enriquemf15/modular-bms/BOM_BMS_PCB.xlsx

Designacion | Reference | Quantity | Value | Footprint | RS Number | RS Link | Inventario | Pedir | Utilizadas | Quedan
C1 | C1 C3 C6 | 3 | 2,2 uF | 1206 | 144-7280 | Condensador 2,2uF (https://es.rs-online.com/web/p/condensadores-ceramicos-multicapa/1447280/) | 40 | 0 | 3 | 37
C21 | C11 C14 C17 C20 C23 C26 | 6 | 2.2 uF | 805 | 885-1685 | Condensador 2.2uF - Filtro (https://es.rs-online.com/web/p/condensadores-ceramicos-multicapa/8851685/) | 0 | 60 | 6 | 54
C5 | C29 C30 C31 C32 C33 C34 | 6 | 33 pF | 805 | 264-4264 | Condensador 33pF (https://es.rs-online.com/web/p/condensadores-ceramicos-multicapa/2644264/) | 57 | 0 | 0 | 57
C4 | C28 | 1 | 10 nF | 603 | 698-3213 | Condensador 10nF (https://es.rs-online.com/web/p/condensadores-ceramicos-multicapa/6983213/) | 97 | 0 | 0 | 97
C31 | C2 C5 C9 C12 C15 C18 C21 C24 C27 | 9 | 0,1 uF | 805 | 723-5048 | Condensador 0,1uF (https://es.rs-online.com/web/p/products/7235048/) | 0 | 100 | 9 | 91
C6 | C4 | 1 | 10 uF | 1206 | 790-0613 | Condensador 10uF (https://es.rs-online.com/web/p/condensadores-ceramicos-multicapa/7900613/) | 17 | 0 | 1 | 16
C7 | C7 C8 | 2 | 47 nF | 603 | 135-6600 | Condensador 47nF (https://es.rs-online.com/web/p/condensadores-ceramicos-multicapa/1356600/) | 44 | 0 | 0 | 44
D1 | D1 | 1 | TVS | SMA | 795-8565 | TVS (https://es.rs-online.com/web/p/products/7958565/) | 17 | 0 | 1 | 16
D2 | D2 | 1 | LED | 603 | 861-0090 | LED (https://es.rs-online.com/web/p/led-visibles/8610090/) | 46 | 0 | 1 | 45
D3 | D3 D4 D5 D6 D7 D8 D9 D10 D11 D12 D13 D14 | 12 | Zener 5,1V | SOD-123F | 738-4951 | Zener (https://es.rs-online.com/web/p/diodos-zener/7384951/) | 160 | 0 | 12 | 148
J2 | J3 | 1 | Switch_3P_SPST | Switch | 718-2140 | Interruptor 3P (https://es.rs-online.com/web/p/interruptores-dip-y-sip/7182140/) | 7 | 0 | 0 | 7
- | J1 J5 J9 J14 | 1 | Conn_01x08 | Pin | - | - | - | - | - | -
J1 | J2 | 1 | IDC | IDC 2x5 | 832-3581 | IDC 2x5 (https://es.rs-online.com/web/p/conectores-macho-para-pcb/8323581/) | 8 | 0 | 1 | 7
J3 | J12 J13 J7 | 3 | Switch_8P_DIP_SPST | Switch | 718-2180 | Interruptor 8P (https://es.rs-online.com/web/p/interruptores-dip-y-sip/7182180/) | 10 | 0 | 2 | 8
U1 | Q1 Q2 Q3 Q4 Q5 Q6 | 6 | NMOS | SOT | 737-7228 | NMOS (https://es.rs-online.com/web/p/transistores-mosfet/7377228/) | 61 | 0 | 6 | 55
R4 | R3 R63 R64 R65 | 4 | 100K | 1206 | 901-3746 | 100K (https://es.rs-online.com/web/p/resistencias-fijas-para-montaje-en-superficie/9013746/) | 97 | 0 | 1 | 96
R2 | R11 R16 R21 R26 R31 R36 | 6 | 33 | 1206 | 721-9706 | 33 (https://es.rs-online.com/web/p/resistencias-fijas-para-montaje-en-superficie/7219706/) | 53 | 10 | 6 | 57
R3 | R10 R12 R15 R17 R20 R22 R25 R27 R30 R32 R35 R37 R55 | 13 | 1K | 603 | 213-2266 | 1K (https://es.rs-online.com/web/p/resistencias-fijas-para-montaje-en-superficie/2132266/) | 155 | 0 | 13 | 142
R1 | R1 R13 R18 R23 R28 R33 R38 | 7 | 1M | 603 | 213-2676 | 1M (https://es.rs-online.com/web/p/resistencias-fijas-para-montaje-en-superficie/2132676/) | 71 | 0 | 7 | 64
R6 | R39 R40 R41 R42 R47 R48 R49 R50 R56 R57 R58 R59 R60 R61 R62 | 15 | 100 | 603 | 873-9214 | 100 (https://es.rs-online.com/web/p/resistencias-fijas-para-montaje-en-superficie/8739214/) | 139 | 0 | 0 | 139
R7 | R43 R44 R45 R46 | 4 | 560K | 603 | 679-0532 | 560K (https://es.rs-online.com/web/p/resistencias-fijas-para-montaje-en-superficie/6790532/) | 50 | 0 | 0 | 50
R5 | R4 | 1 | NTC Thermistor | Pin | 697-4578 | NTC (https://es.rs-online.com/web/p/termistores/6974578/) | 16 | 0 | 0 | 16
R10 | R51 R52 R53 R54 | 4 | 3 M | 603 | 679-0346 | 3M (https://es.rs-online.com/web/p/resistencias-fijas-para-montaje-en-superficie/6790346/) | 50 | 0 | 0 | 50
R11 | R8 | 1 | 1.5 K | 805 | 679-1014 | 1.5K (https://es.rs-online.com/web/p/resistencias-fijas-para-montaje-en-superficie/6791014/) | 42 | 0 | 1 | 41
R9 | R2 R6 | 2 | 1,74K | 603 | 678-9923 | 1.74K (https://es.rs-online.com/web/p/resistencias-fijas-para-montaje-en-superficie/6789923/) | 44 | 0 | 0 | 44
R8 | R5 R7 | 2 | 1,78K | 603 | 651-7380 | 1.78K (https://es.rs-online.com/web/p/resistencias-fijas-para-montaje-en-superficie/6517380/) | 14 | 20 | 0 | 34
BQ | U1 | 1 | BQ76PL536A_Q1 | HTQP-64 | 742-2848 | BQ (https://es.rs-online.com/web/p/circuitos-integrados-de-indicador-de-combustible-de-bateria/7422848/) | 1 | 10 | 1 | 10
