enriquemf15/modular-bms/Librerias/Fuentes/IRLML6244TRPBF/3D/IRLML6244TRPBF.stp

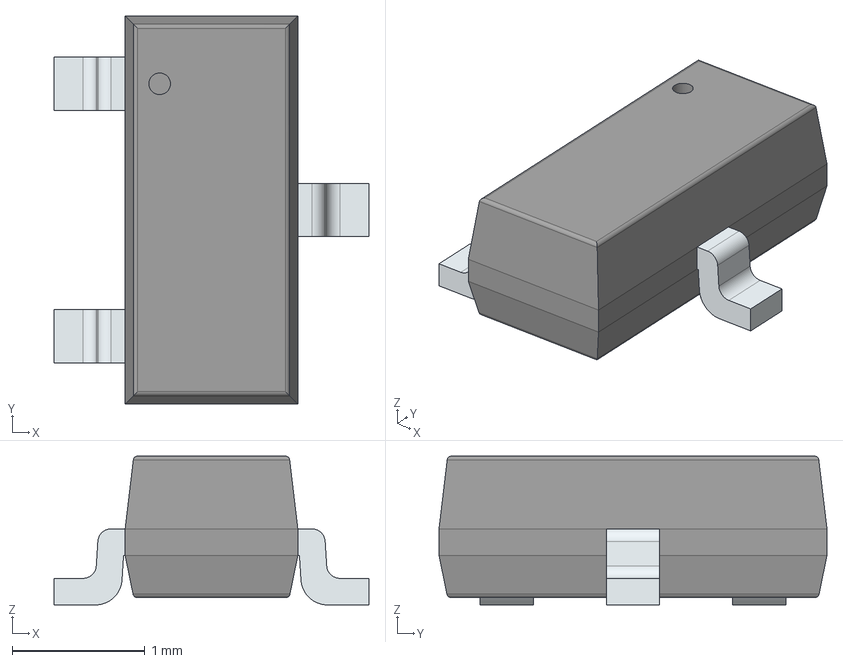
[picture p1: CAD file, 2018-08-12]
Librerias/Fuentes/IRLML6244TRPBF/3D/IRLML6244TRPBF.stp
2.37 x 2.92 x 1.12 mm
PinsArrayL
FilletPinR
