enriquemf15/modular-bms/Modelo 3D/Montaje/Montaje_PCB.step

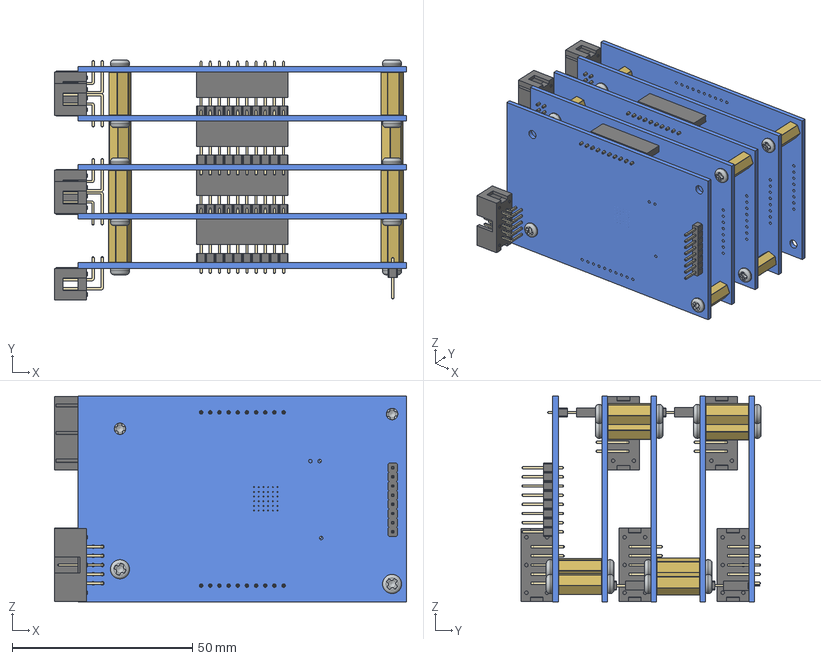
[picture p2: CAD file, 2018-08-12]
Modelo 3D/Montaje/Montaje_PCB.step
97.6 x 66.6 x 57.0 mm
PCB_BMS x 5
IDC_Header_2x05_P254mm_Horizontal__1 x 5
Pin_Header_Straight_1x10_Pitch254mm__1 x 4
PinSocket_1x10_P254mm_Vertical__1 x 4
Separador M3x12 x 8
M3x6 Philips Screw x 16
Pin_Header_Straight_1x08_Pitch254mm__1
