enriquemf15/modular-bms/Modelo 3D/NMOS/Fusion.step

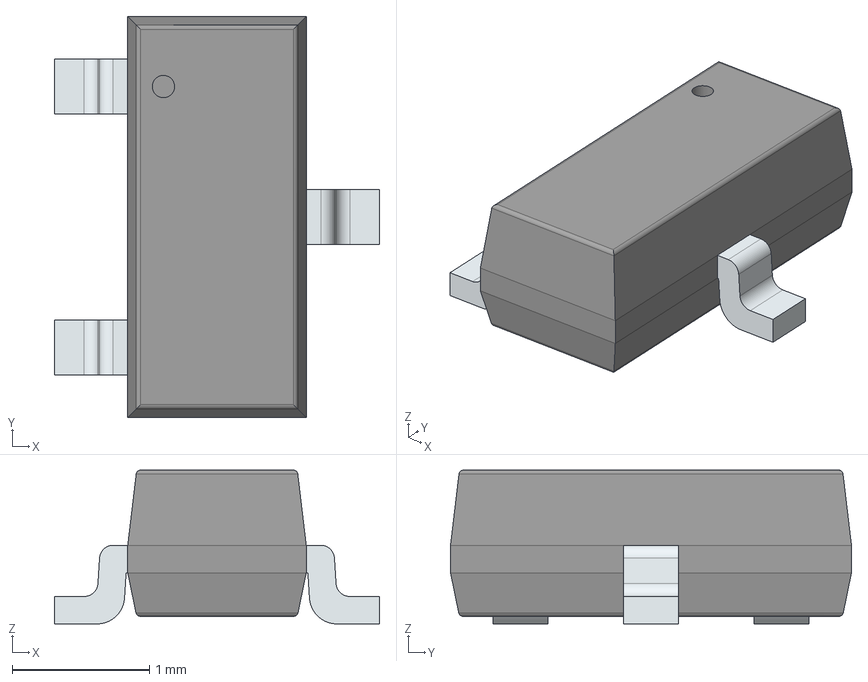
[picture p3: CAD file, 2018-08-12]
Modelo 3D/NMOS/Fusion.step
2.37 x 2.92 x 1.12 mm
