enriquemf15/modular-bms/Modelo 3D/Switch_3P/Fusion.step

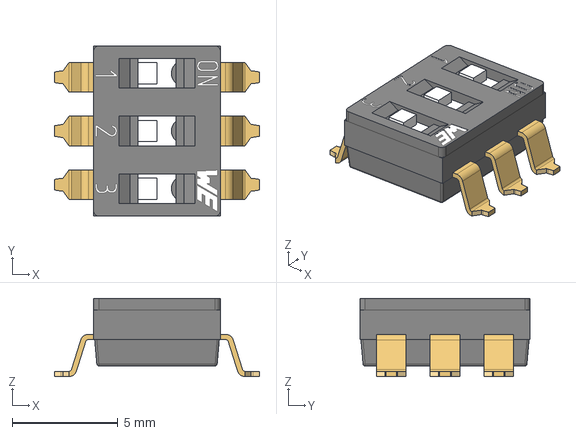
[picture p4: CAD file, 2018-08-12]
Modelo 3D/Switch_3P/Fusion.step
9.70 x 8.06 x 3.70 mm
