enriquemf15/modular-bms/Modelo 3D/Switch_8P/Fusion.step

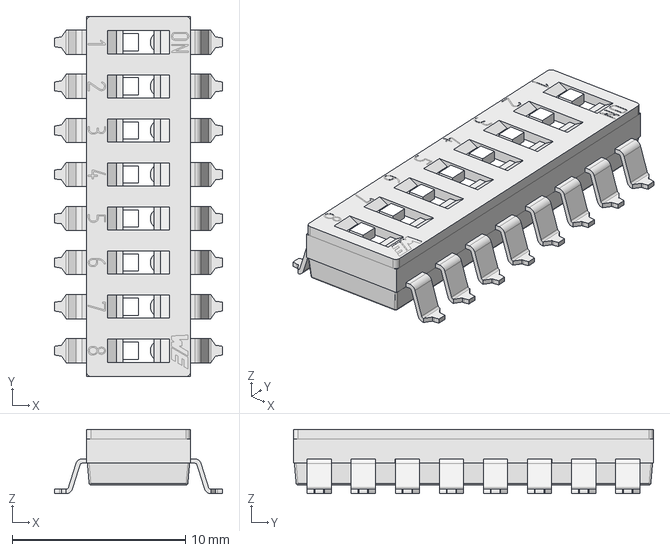
[picture p5: CAD file, 2018-08-12]
Modelo 3D/Switch_8P/Fusion.step
9.70 x 20.8 x 3.70 mm
