enriquemf15/modular-bms/Modelo 3D/Switch_3P/43615.stp

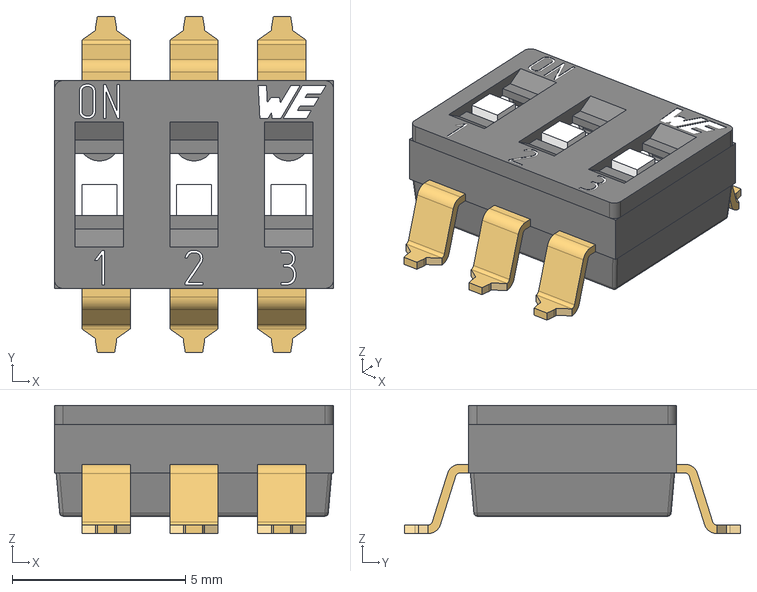
[picture p6: CAD file, 2018-08-12]
Modelo 3D/Switch_3P/43615.stp
8.06 x 9.70 x 3.70 mm
