enriquemf15/modular-bms/Modelo 3D/Switch_8P/43611.stp

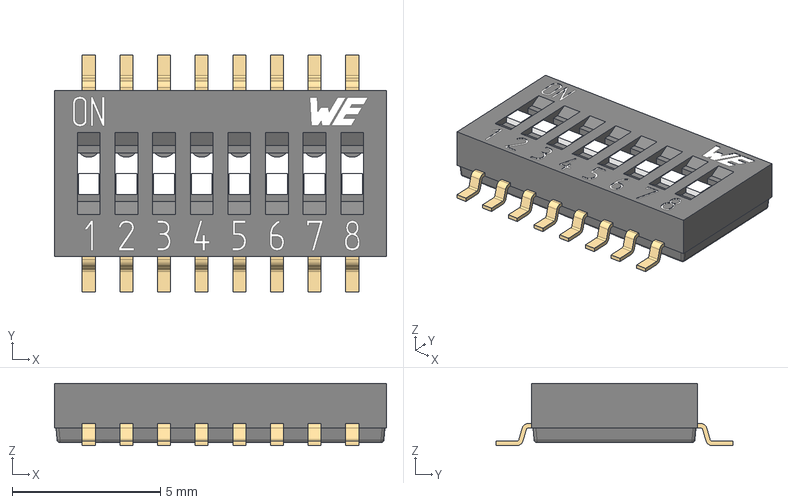
[picture p7: CAD file, 2018-08-12]
Modelo 3D/Switch_8P/43611.stp
11.2 x 8.00 x 2.10 mm
