enriquemf15/modular-bms/Modelo 3D/Switch_8P/43619.stp

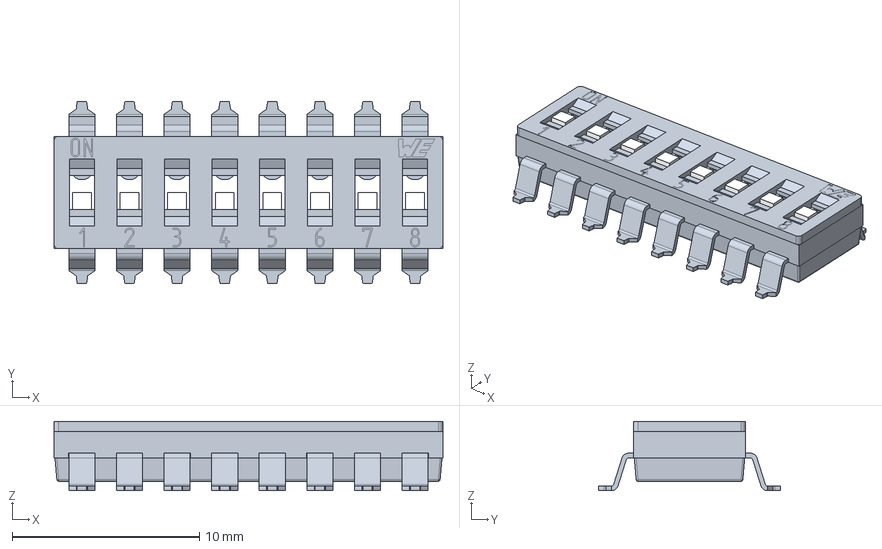
[picture p8: CAD file, 2018-08-12]
Modelo 3D/Switch_8P/43619.stp
20.8 x 9.70 x 3.70 mm
