enriquemf15/modular-bms/(list of files, cad)

Other CAD files:
Librerias/Fuentes/IRLML6244TRPBF/3D/IRLML6244TRPBF.stl
