enriquemf15/modular-bms/PCB/BMS_PCB.kicad_pcb

## KiCad design PCB/BMS_PCB.kicad_pcb (2018-08-12)

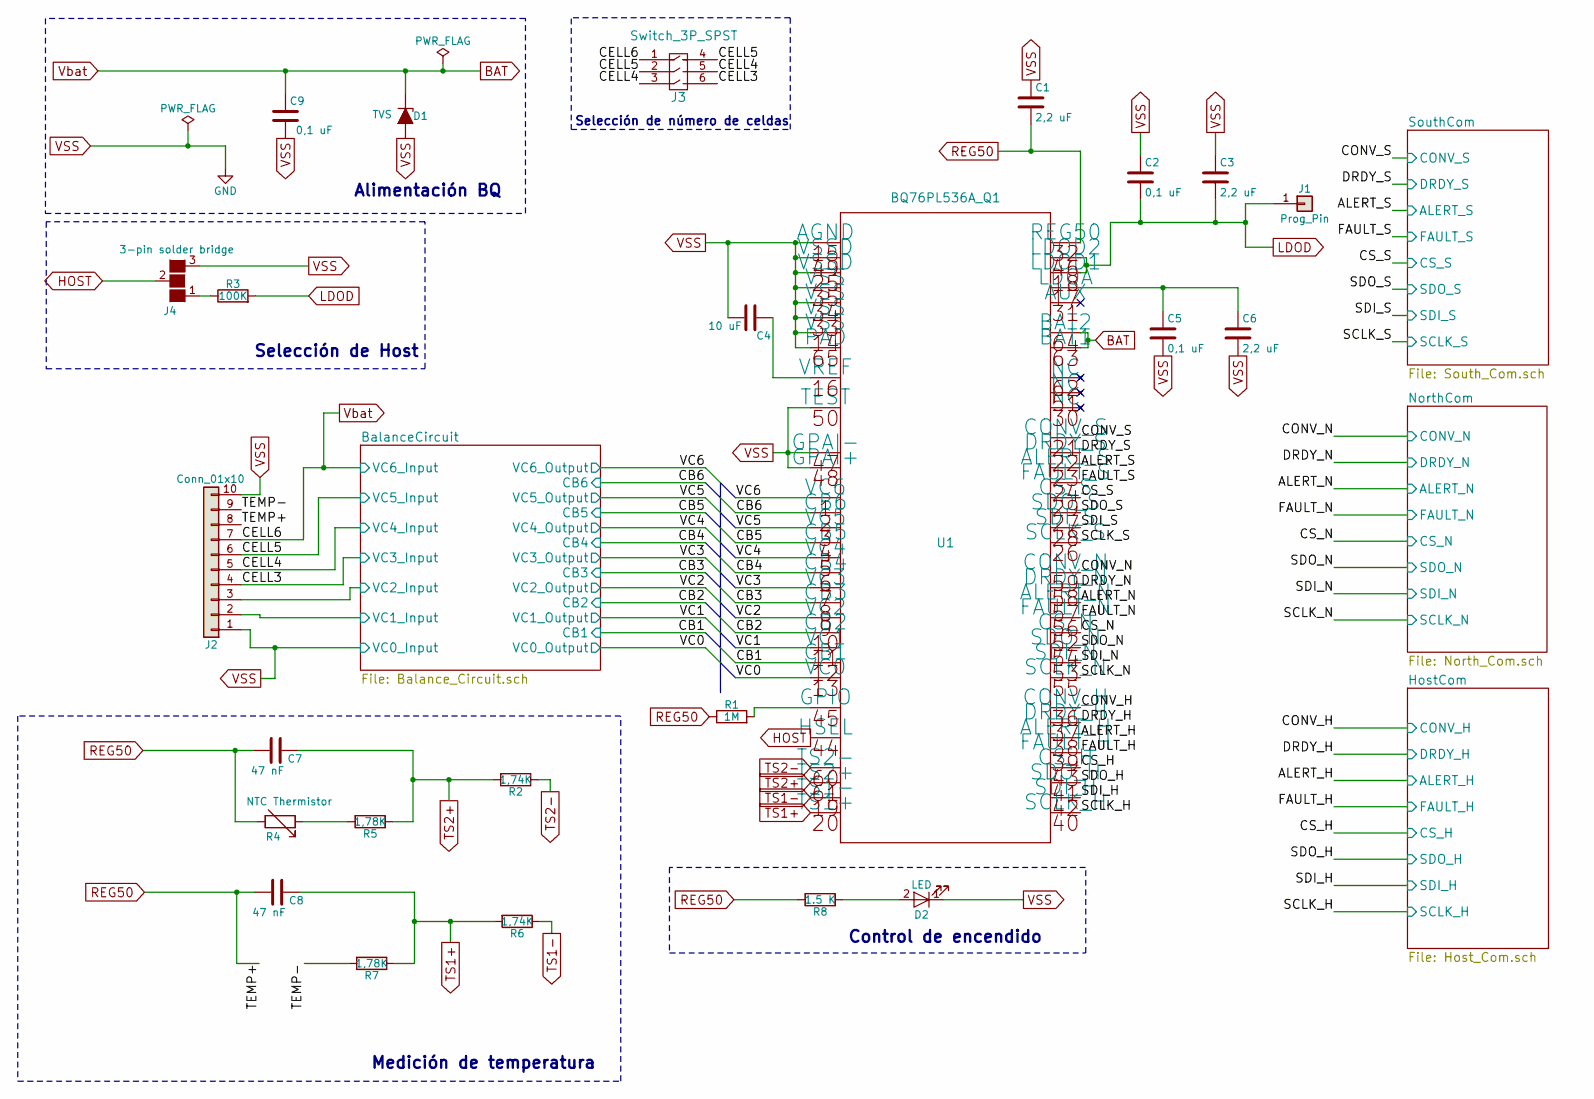
[picture p14: schematic BMS_PCB.sch, BMS]

Parts:
C1, C3, C6: 2,2 uF; C_1206; MFG Part Num CGA5L2X7R1E225K160AA
C2, C5: 0,1 uF; C_0805_HandSoldering; MFG Part Num C1206X104J3JACAUTO
C4: 10 uF; C_1206; MFG Part Num C1206C106J3RACAUTO
C7, C8: 47 nF; C_0603_HandSoldering; MFG Part Num CC0402KRX7R8BB473
C9: 0,1 uF; C_0805_HandSoldering; MFG Part Num C0603C104K5RACAUTO
D1: TVS; D_SMA
D2: LED; LED_0603_HandSoldering; MFG Part Num LG Q396
J1: Prog_Pin; Pin_Header_Straight_1x01_Pitch2.54mm
J2: Conn_01x10; IDC-Header_2x05_Pitch2.54mm_Angled
J3: Switch_3P_SPST; 1-1825059-2; MFG Part Num 1-1825059-2
J4: 3-pin solder bridge; GS3
R1: 1M; R_0603_HandSoldering; MFG Part Num ERJP14F1004U
R2, R6: 1,74K; R_0603_HandSoldering; MFG Part Num ERJ3EKF1741V
R3: 100K; R_1206; MFG Part Num ERJP08F1003V
R4: NTC Thermistor; Pin_Header_Straight_1x02_Pitch2.54mm; MFG Part Num NJ28NA0103FCC
R5, R7: 1,78K; R_0603_HandSoldering; MFG Part Num ERJ3EKF1781V
R8: 1.5 K; R_0805_HandSoldering; MFG Part Num RC0402JR-071K5L
U1: BQ76PL536A_Q1; HTQFP-64_1EP_10x10mm_Pitch0.5mm_ThermalPad; MFG Part Num bq76PL536A-Q1

Connections:
/ALERT_H: U1.38 (ALERT_H); also elsewhere on the board
/ALERT_N: U1.57 (ALERT_N); also elsewhere on the board
/ALERT_S: U1.23 (ALERT_S); also elsewhere on the board
/BalanceCircuit/VC1_Input: J2.2; also elsewhere on the board
/BalanceCircuit/VC2_Input: J2.3; also elsewhere on the board
/CB1: U1.12 (CB1); also elsewhere on the board
/CB2: U1.10 (CB2); also elsewhere on the board
/CB3: U1.8 (CB3); also elsewhere on the board
/CB4: U1.6 (CB4); also elsewhere on the board
/CB5: U1.4 (CB5); also elsewhere on the board
/CB6: U1.2 (CB6); also elsewhere on the board
/CELL3: J2.4, J3.6 (OUT3); also elsewhere on the board
/CELL4: J2.5, J3.3 (IN3), J3.5 (OUT2); also elsewhere on the board
/CELL5: J2.6, J3.2 (IN2), J3.4 (OUT1); also elsewhere on the board
/CONV_H: U1.36 (CONV_H); also elsewhere on the board
/CONV_N: U1.59 (CONV_N); also elsewhere on the board
/CONV_S: U1.21 (CONV_S); also elsewhere on the board
/CS_H: U1.43 (CS_H); also elsewhere on the board
/CS_N: U1.52 (CS_N); also elsewhere on the board
/CS_S: U1.29 (CS_S); also elsewhere on the board
/DRDY_H: U1.37 (DRDY_H); also elsewhere on the board
/DRDY_N: U1.58 (DRDY_N); also elsewhere on the board
/DRDY_S: U1.22 (DRDY_S); also elsewhere on the board
/FAULT_H: U1.39 (FAULT_H); also elsewhere on the board
/FAULT_N: U1.56 (FAULT_N); also elsewhere on the board
/FAULT_S: U1.24 (FAULT_S); also elsewhere on the board
/SCLK_H: U1.40 (SCLK_H); also elsewhere on the board
/SCLK_N: U1.55 (SCLK_N); also elsewhere on the board
/SCLK_S: U1.26 (SCLK_S); also elsewhere on the board
/SDI_H: U1.42 (SDI_H); also elsewhere on the board
/SDI_N: U1.53 (SDI_N); also elsewhere on the board
/SDI_S: U1.28 (SDI_S); also elsewhere on the board
/SDO_H: U1.41 (SDO_H); also elsewhere on the board
/SDO_N: U1.54 (SDO_N); also elsewhere on the board
/SDO_S: U1.27 (SDO_S); also elsewhere on the board
/TEMP-: J2.9, R7.2
/VC1: U1.11 (VC1); also elsewhere on the board
/VC2: U1.9 (VC2); also elsewhere on the board
/VC3: U1.7 (VC3); also elsewhere on the board
/VC4: U1.5 (VC4); also elsewhere on the board
/VC5: U1.3 (VC5); also elsewhere on the board
/VC6: U1.1 (VC6); also elsewhere on the board
BAT: C9.1, D1.1 (K), J2.7, J3.1 (IN1), U1.63 (BAT1), U1.64 (BAT2); also elsewhere on the board
HOST: J4.2 (G2), U1.44 (HSEL)
LDOD: C2.2, C3.2, J1.1, R3.2, U1.18 (LDOD1), U1.46 (LDOD2)
unnamed: C4.1, U1.16 (VREF)
unnamed: C5.1, C6.1, U1.17 (LDOA)
unnamed: D2.2 (A), R8.1
unnamed: J4.1 (G1), R3.1
unnamed: R1.2, U1.45 (GPIO)
unnamed: R4.1, R5.2
REG50: C1.2, C7.2, C8.2, J2.8, R1.1, R4.2, R8.2, U1.32 (REG50); also elsewhere on the board
TS1+: C8.1, R6.2, R7.1, U1.20 (TS1+)
TS1-: R6.1, U1.19 (TS1-)
TS2+: C7.1, R2.2, R5.1, U1.61 (TS2+)
TS2-: R2.1, U1.60 (TS2-)
VSS: C1.1, C2.1, C3.1, C4.2, C5.2, C6.2, C9.2, D1.2 (A), D2.1 (K), J2.1, J2.10, J4.3 (G3), U1.13 (VC0), U1.14 (VSS), U1.15 (AGND), U1.25 (VSSD), U1.33 (VSS), U1.34 (VSS), U1.35 (VSS), U1.47 (GPAI-), U1.48 (GPAI+), U1.49 (VSSD), U1.50 (TEST), U1.65 (PAD); also elsewhere on the board

Notes on the sheet:
Alimentación BQ
Selección de Host
Medición de temperatura
Control de encendido
Selección de número de celdas

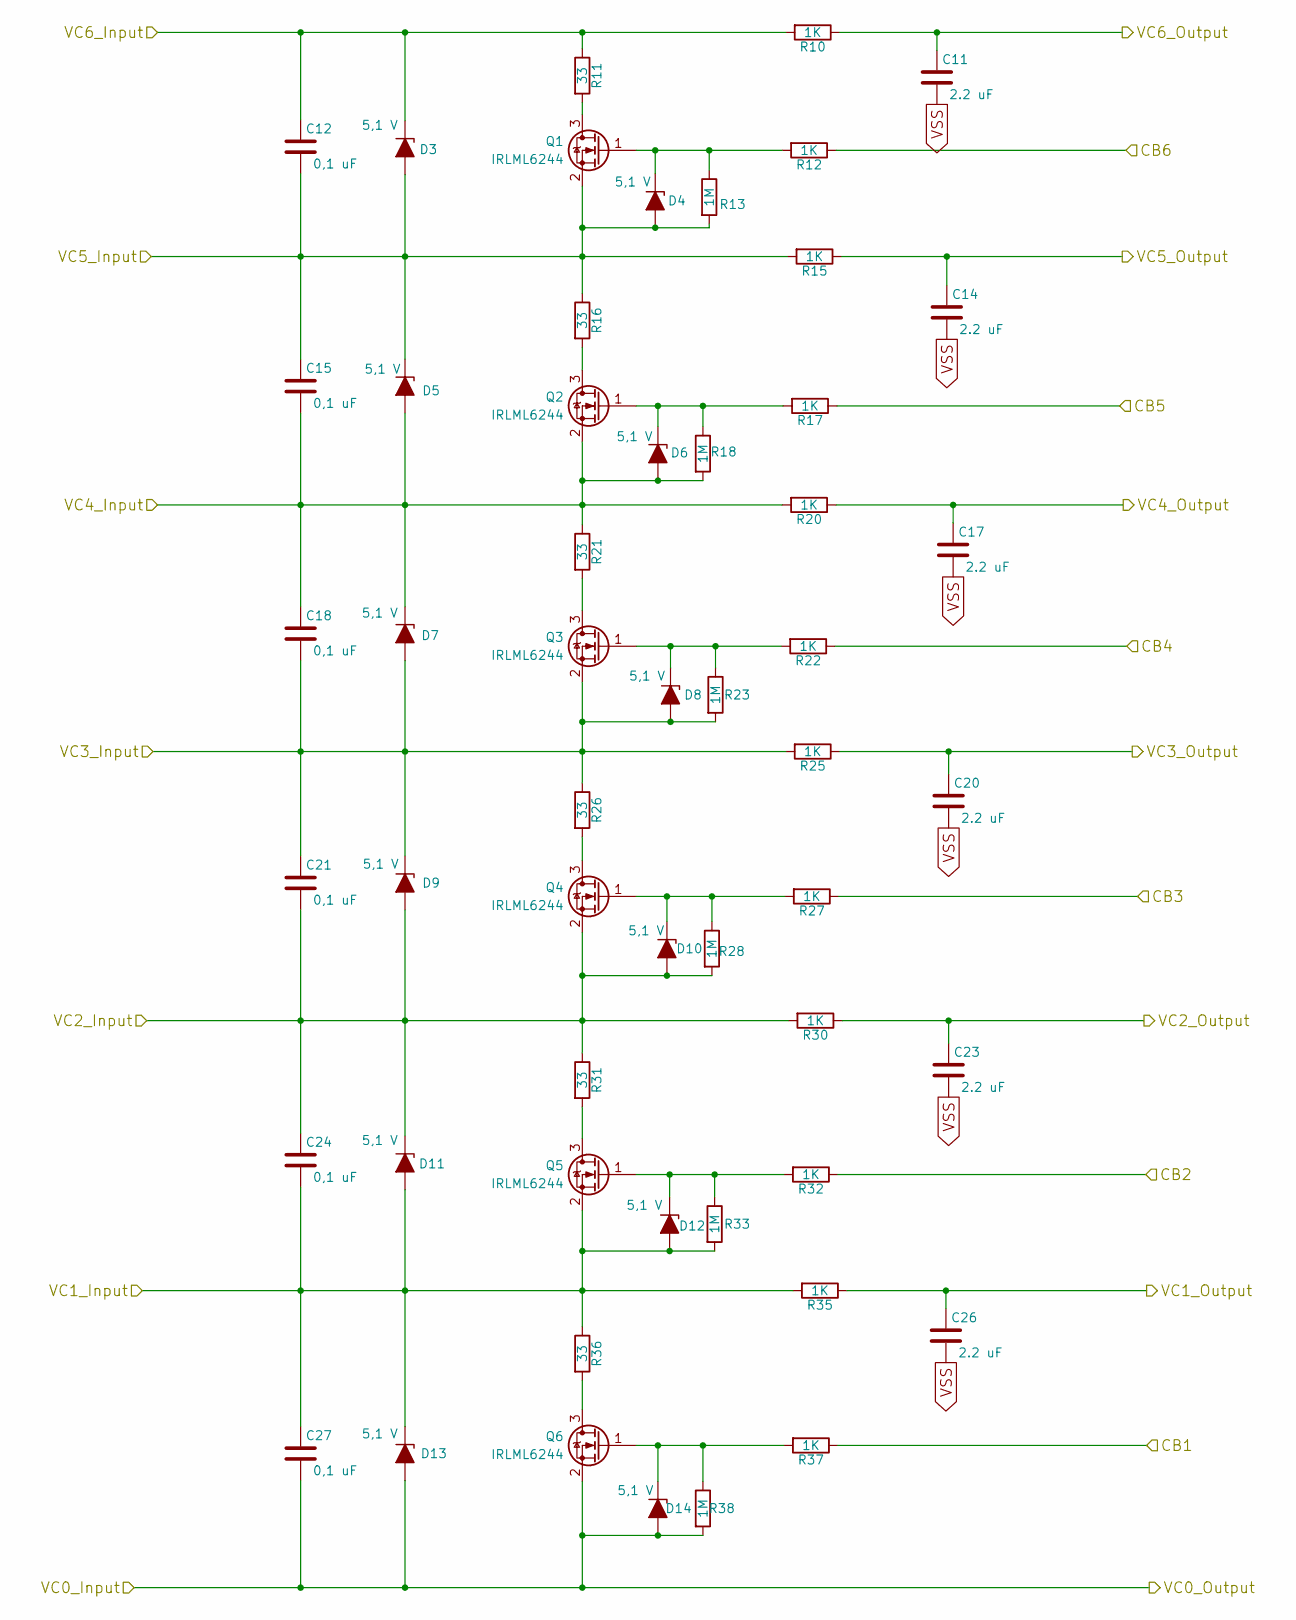
[picture p15: schematic Balance_Circuit.sch, Circuito de balanceo]

Parts:
C11, C14, C17, C20, C23, C26: 2.2 uF; C_0805_HandSoldering; MFG Part Num C0603C104K5RACAUTO
C12, C15, C18, C21, C24, C27: 0,1 uF; C_0805_HandSoldering; MFG Part Num C0603C104K5RACAUTO
D3, D4, D5, D6, D7, D8, D9, D10, D11, D12, D13, D14: 5,1 V; D_SOD-123F; MFG Part Num BZT52H-B5V1
Q1, Q2, Q3, Q4, Q5, Q6: IRLML6244; SOT95P237X112-3N
R10, R12, R15, R17, R20, R22, R25, R27, R30, R32, R35, R37: 1K; R_0603_HandSoldering; MFG Part Num ERJ14NF1001U
R11, R16, R21, R26, R31, R36: 33; R_1206; MFG Part Num ERJP08F33R0V
R13, R18, R23, R28, R33, R38: 1M; R_0603_HandSoldering; MFG Part Num ERJP14F1004U

Connections:
/BalanceCircuit/VC1_Input: C24.2, C27.1, D11.2 (A), D12.2 (A), D13.1 (K), Q5.2 (S), R33.2, R35.2, R36.1; also elsewhere on the board
/BalanceCircuit/VC2_Input: C21.2, C24.1, D9.2 (A), D10.2 (A), D11.1 (K), Q4.2 (S), R28.2, R30.2, R31.1; also elsewhere on the board
/CB1: R37.1; also elsewhere on the board
/CB2: R32.1; also elsewhere on the board
/CB3: R27.1; also elsewhere on the board
/CB4: R22.1; also elsewhere on the board
/CB5: R17.1; also elsewhere on the board
/CB6: R12.1; also elsewhere on the board
/CELL3: C18.2, C21.1, D7.2 (A), D8.2 (A), D9.1 (K), Q3.2 (S), R23.2, R25.2, R26.1; also elsewhere on the board
/CELL4: C15.2, C18.1, D5.2 (A), D6.2 (A), D7.1 (K), Q2.2 (S), R18.2, R20.2, R21.1; also elsewhere on the board
/CELL5: C12.2, C15.1, D3.2 (A), D4.2 (A), D5.1 (K), Q1.2 (S), R13.2, R15.2, R16.1; also elsewhere on the board
/VC1: C26.1, R35.1; also elsewhere on the board
/VC2: C23.1, R30.1; also elsewhere on the board
/VC3: C20.1, R25.1; also elsewhere on the board
/VC4: C17.1, R20.1; also elsewhere on the board
/VC5: C14.1, R15.1; also elsewhere on the board
/VC6: C11.1, R10.1; also elsewhere on the board
BAT: C12.1, D3.1 (K), R10.2, R11.1; also elsewhere on the board
unnamed: D4.1 (K), Q1.1 (G), R12.2, R13.1
unnamed: D6.1 (K), Q2.1 (G), R17.2, R18.1
unnamed: D8.1 (K), Q3.1 (G), R22.2, R23.1
unnamed: D10.1 (K), Q4.1 (G), R27.2, R28.1
unnamed: D12.1 (K), Q5.1 (G), R32.2, R33.1
unnamed: D14.1 (K), Q6.1 (G), R37.2, R38.1
unnamed: Q1.3 (D), R11.2
unnamed: Q2.3 (D), R16.2
unnamed: Q3.3 (D), R21.2
unnamed: Q4.3 (D), R26.2
unnamed: Q5.3 (D), R31.2
unnamed: Q6.3 (D), R36.2
VSS: C11.2, C14.2, C17.2, C20.2, C23.2, C26.2, C27.2, D13.2 (A), D14.2 (A), Q6.2 (S), R38.2; also elsewhere on the board

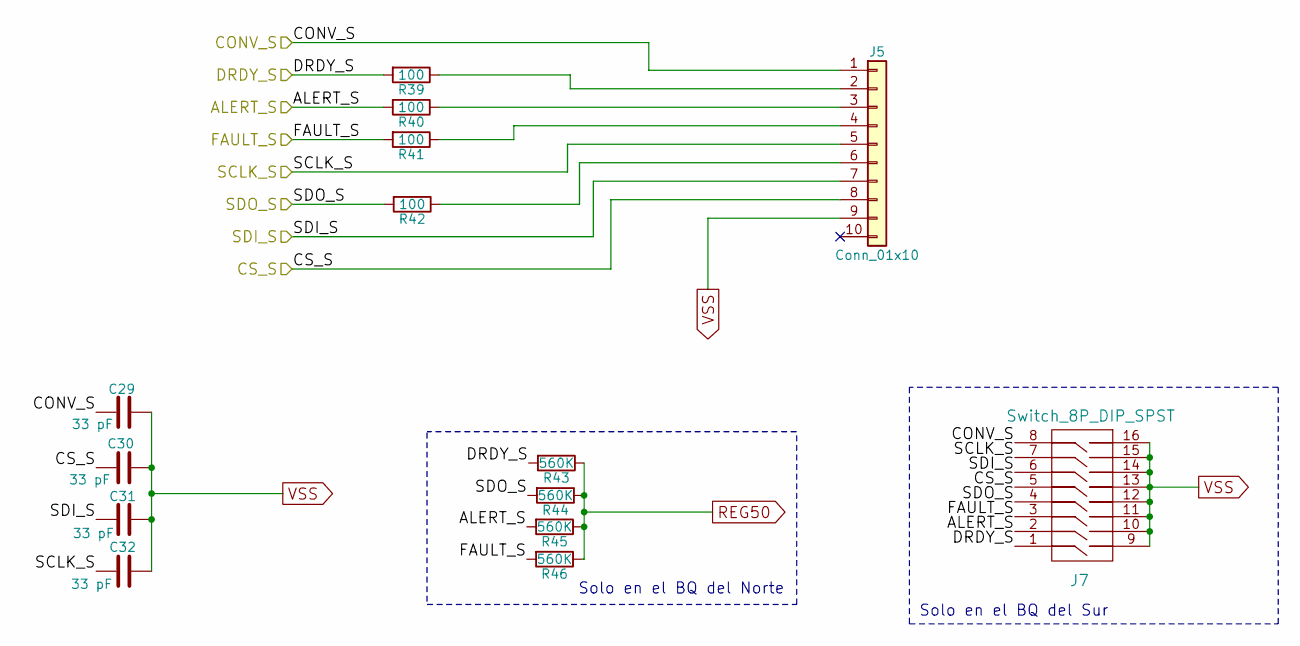
[picture p16: schematic South_Com.sch, Comunicación Sur]

Parts:
C29, C30, C31, C32: 33 pF; C_0805_HandSoldering; MFG Part Num CC0402JRNPO9BN330
J5: Conn_01x10; Pin_Header_Straight_1x10_Pitch2.54mm
J7: Switch_8P_DIP_SPST; 4-1825059-1; MFG Part Num 4-1825059-1
R39, R40, R41, R42: 100; R_0603_HandSoldering; MFG Part Num ERJP08F1000V
R43, R44, R45, R46: 560K; R_0603_HandSoldering; MFG Part Num RC0603JR-07560KL

Connections:
/ALERT_S: J7.2 (IN2), R40.2, R45.2; also elsewhere on the board
/CONV_S: C29.1, J5.1, J7.8 (IN8); also elsewhere on the board
/CS_S: C30.1, J5.8, J7.5 (IN5); also elsewhere on the board
/DRDY_S: J7.1 (IN1), R39.2, R43.2; also elsewhere on the board
/FAULT_S: J7.3 (IN3), R41.2, R46.2; also elsewhere on the board
/SCLK_S: C32.1, J5.5, J7.7 (IN7); also elsewhere on the board
/SDI_S: C31.1, J5.7, J7.6 (IN6); also elsewhere on the board
/SDO_S: J7.4 (IN4), R42.2, R44.2; also elsewhere on the board
unnamed: J5.2, R39.1
unnamed: J5.3, R40.1
unnamed: J5.4, R41.1
unnamed: J5.6, R42.1
REG50: R43.1, R44.1, R45.1, R46.1; also elsewhere on the board
VSS: C29.2, C30.2, C31.2, C32.2, J5.9, J7.9 (OUT1), J7.10 (OUT2), J7.11 (OUT3), J7.12 (OUT4), J7.13 (OUT5), J7.14 (OUT6), J7.15 (OUT7), J7.16 (OUT8); also elsewhere on the board

Notes on the sheet:
Solo en el BQ del Norte
Solo en el BQ del Sur

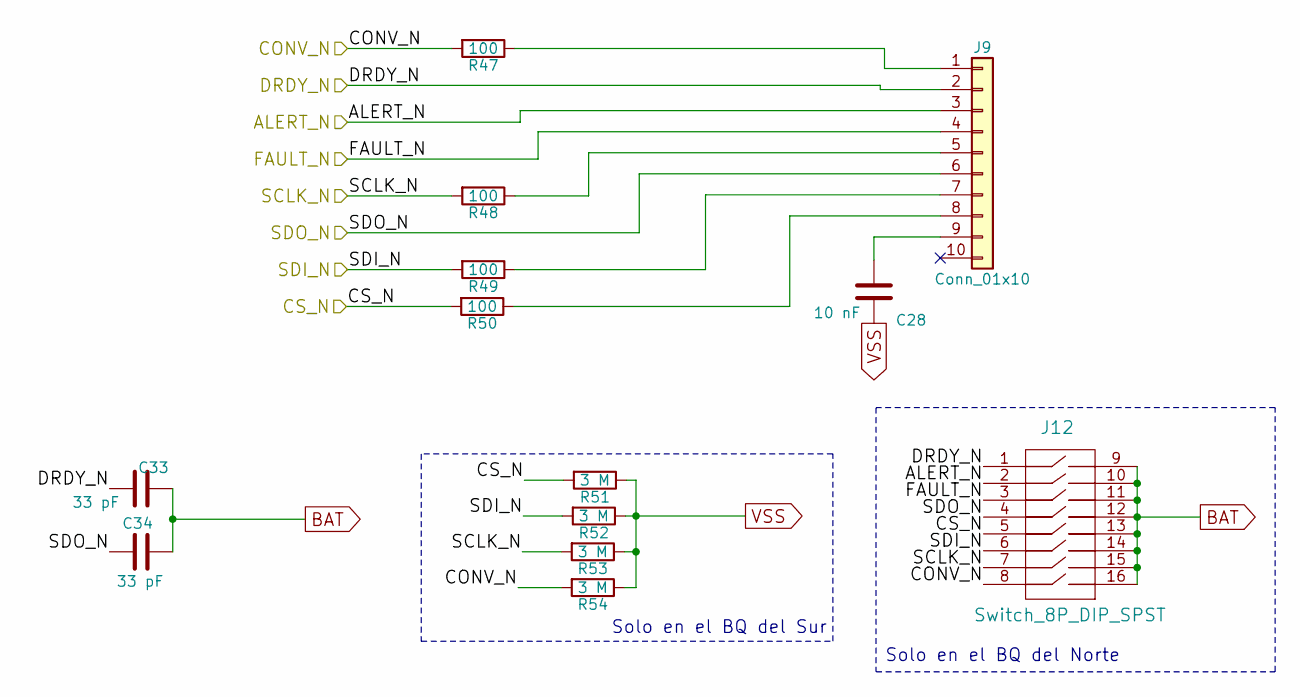
[picture p17: schematic North_Com.sch, Comunicacion Norte]

Parts:
C28: 10 nF; C_0603_HandSoldering; MFG Part Num CC0402KRX7R9BB103
C33, C34: 33 pF; C_0805_HandSoldering; MFG Part Num CC0402JRNPO9BN330
J9: Conn_01x10; Pin_Header_Straight_1x10_Pitch2.54mm
J12: Switch_8P_DIP_SPST; 4-1825059-1; MFG Part Num 4-1825059-1
R47, R48, R49, R50: 100; R_0603_HandSoldering; MFG Part Num ERJP08F1000V
R51, R52, R53, R54: 3 M; R_0603_HandSoldering; MFG Part Num CRCW06033M30FKEA

Connections:
/ALERT_N: J9.3, J12.2 (IN2); also elsewhere on the board
/CONV_N: J12.8 (IN8), R47.2, R54.2; also elsewhere on the board
/CS_N: J12.5 (IN5), R50.2, R51.2; also elsewhere on the board
/DRDY_N: C33.1, J9.2, J12.1 (IN1); also elsewhere on the board
/FAULT_N: J9.4, J12.3 (IN3); also elsewhere on the board
/SCLK_N: J12.7 (IN7), R48.2, R53.2; also elsewhere on the board
/SDI_N: J12.6 (IN6), R49.2, R52.2; also elsewhere on the board
/SDO_N: C34.1, J9.6, J12.4 (IN4); also elsewhere on the board
BAT: C33.2, C34.2, J12.9 (OUT1), J12.10 (OUT2), J12.11 (OUT3), J12.12 (OUT4), J12.13 (OUT5), J12.14 (OUT6), J12.15 (OUT7), J12.16 (OUT8); also elsewhere on the board
unnamed: C28.1, J9.9
unnamed: J9.1, R47.1
unnamed: J9.5, R48.1
unnamed: J9.7, R49.1
unnamed: J9.8, R50.1
VSS: C28.2, R51.1, R52.1, R53.1, R54.1; also elsewhere on the board

Notes on the sheet:
Solo en el BQ del Sur
Solo en el BQ del Norte

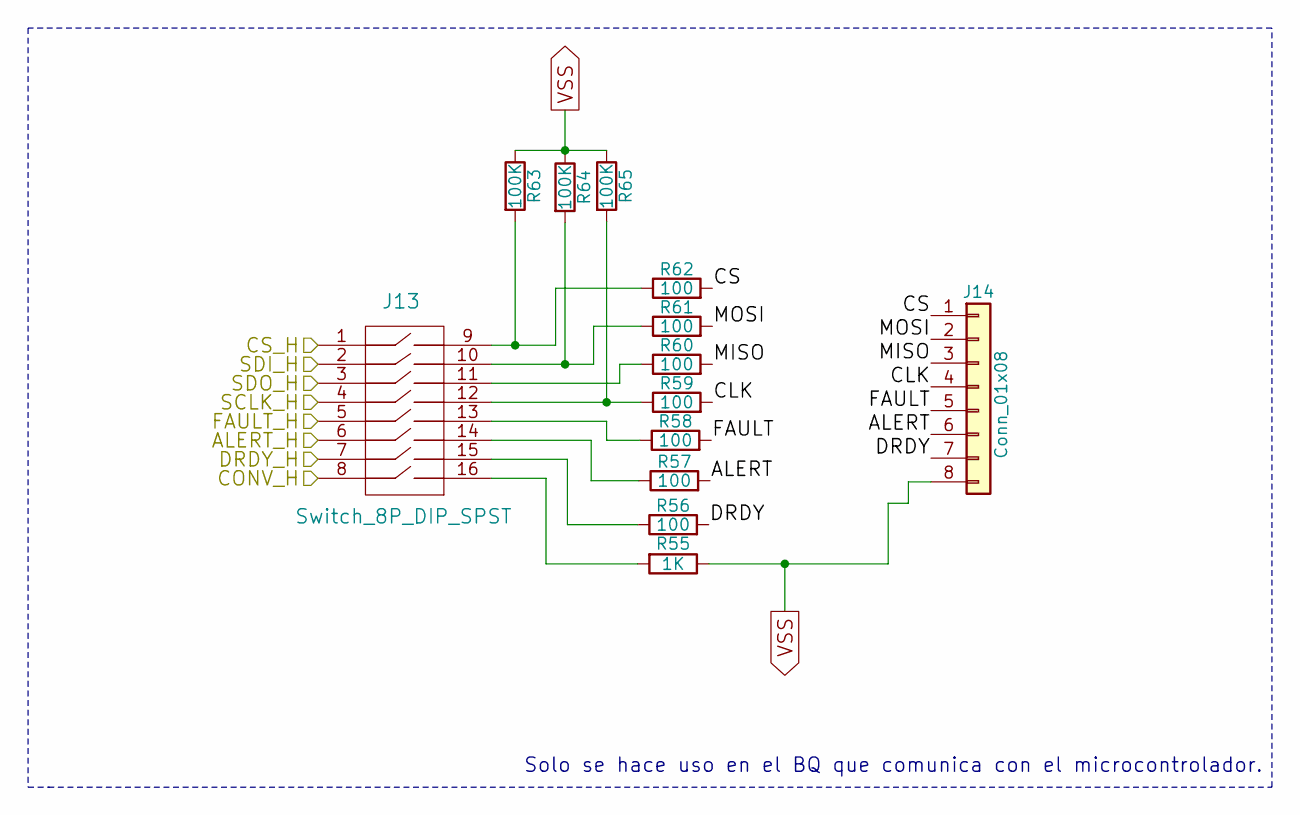
[picture p18: schematic Host_Com.sch, Comunicacion Host]

Parts:
J13: Switch_8P_DIP_SPST; 4-1825059-1; MFG Part Num 4-1825059-1
J14: Conn_01x08; Pin_Header_Straight_1x08_Pitch2.54mm
R55: 1K; R_0603_HandSoldering; MFG Part Num ERJ14NF1001U
R56, R57, R58, R59, R60, R61, R62: 100; R_0603_HandSoldering; MFG Part Num ERJP08F1000V
R63, R64, R65: 100K; R_1206

Connections:
/ALERT_H: J13.6 (IN6); also elsewhere on the board
/CONV_H: J13.8 (IN8); also elsewhere on the board
/CS_H: J13.1 (IN1); also elsewhere on the board
/DRDY_H: J13.7 (IN7); also elsewhere on the board
/FAULT_H: J13.5 (IN5); also elsewhere on the board
/HostCom/ALERT: J14.6, R57.2
/HostCom/CLK: J14.4, R59.2
/HostCom/CS: J14.1, R62.2
/HostCom/DRDY: J14.7, R56.2
/HostCom/FAULT: J14.5, R58.2
/HostCom/MISO: J14.3, R60.2
/HostCom/MOSI: J14.2, R61.2
/SCLK_H: J13.4 (IN4); also elsewhere on the board
/SDI_H: J13.2 (IN2); also elsewhere on the board
/SDO_H: J13.3 (IN3); also elsewhere on the board
unnamed: J13.9 (OUT1), R62.1, R63.2
unnamed: J13.10 (OUT2), R61.1, R64.2
unnamed: J13.11 (OUT3), R60.1
unnamed: J13.12 (OUT4), R59.1, R65.2
unnamed: J13.13 (OUT5), R58.1
unnamed: J13.14 (OUT6), R57.1
unnamed: J13.15 (OUT7), R56.1
unnamed: J13.16 (OUT8), R55.2
VSS: J14.8, R55.1, R63.1, R64.1, R65.1; also elsewhere on the board

Notes on the sheet:
Solo se hace uso en el BQ que comunica con el microcontrolador.

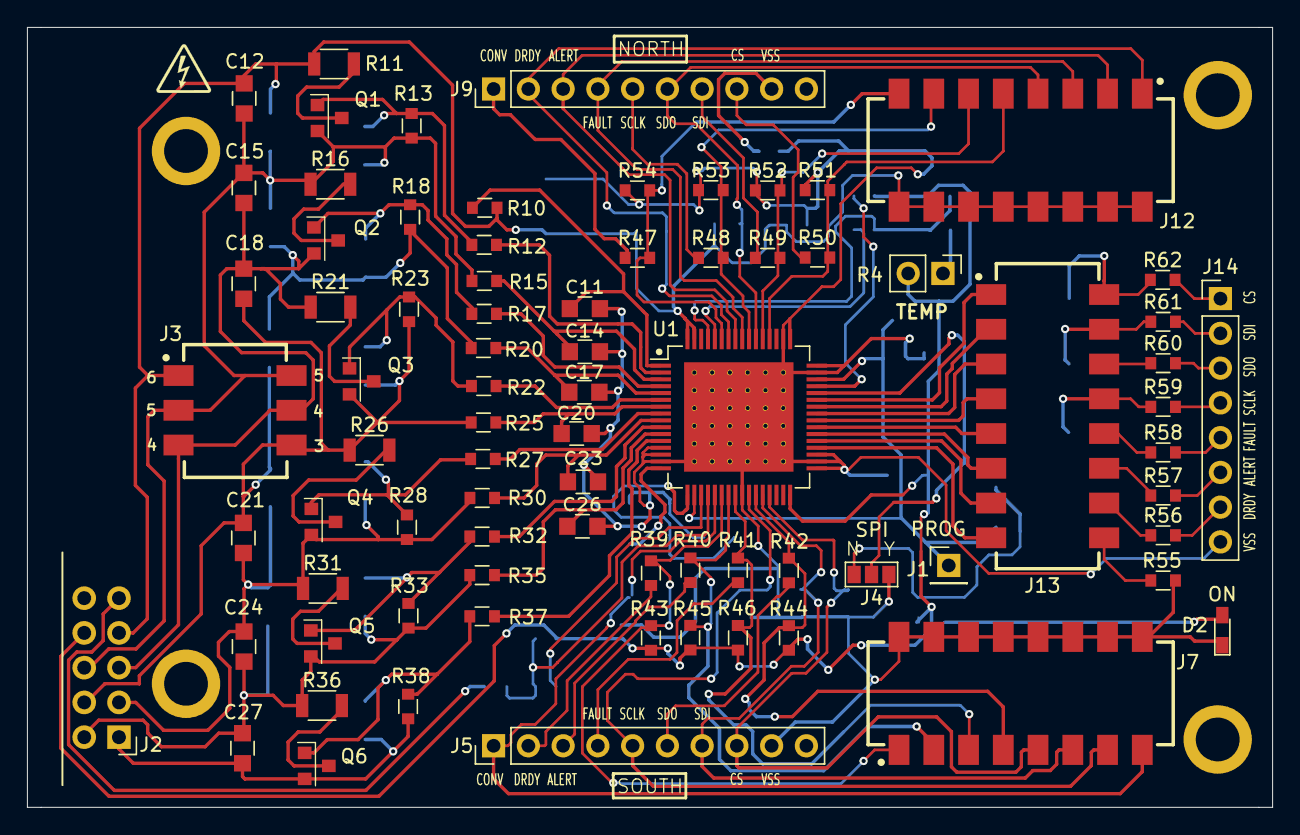
[picture p19: board BMS_PCB.kicad_pcb from above]

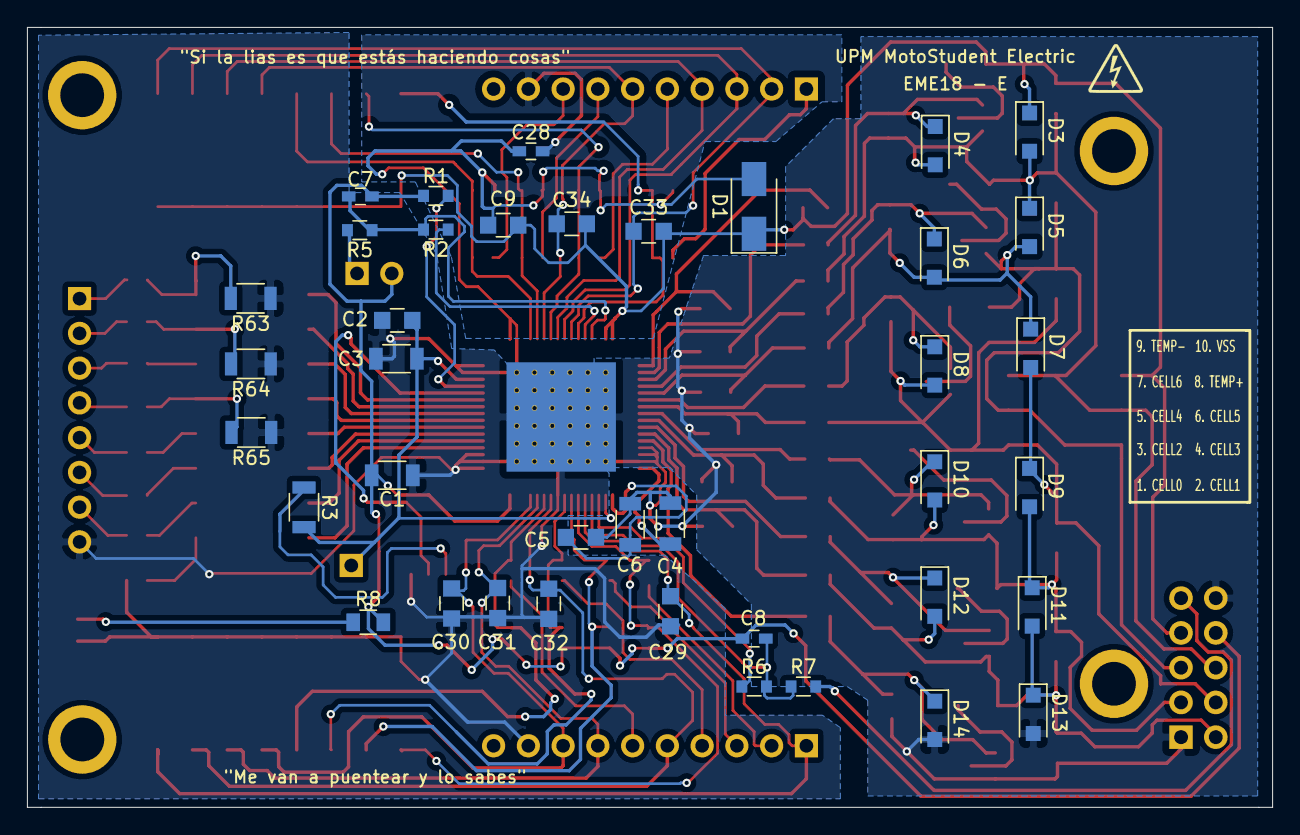
[picture p20: board BMS_PCB.kicad_pcb from below]

Board: 2 copper layers, 91.0 x 57.0 mm, 118 parts (39 on the bottom side), 93 nets.
