enriquemf15/modular-bms/(commit log)

2018-08-12 PCB
    Archivos completos de la PCB en el programa KiCad.
    [BMS_PCB.kicad_pcb, BMS_PCB.sch, Balance_Circuit.sch, Host_Com.sch, North_Com.sch, South_Com.sch]
2018-08-12 Gerber, Librerias, 3D, BOM
    Archivos añadidos para Kicad, los archivos Gerber generados, la lista de materiales completa utilizada y un modelo 3D de un posible montaje de las PCB
    [43611.stp, 43615.stp, 43619.stp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]
